ccccccj123/c8t6_control_mecanum/docs/superpowers/specs/2026-04-24-stm32f103-mecanum-car-design.md

# STM32F103C8T6 麦轮小车 Keil 工程设计说明

## 目标

创建一个可在 Keil uVision 中打开和编译的 STM32F103C8T6 工程，用于驱动四轮麦轮小车。硬件包括：

- STM32F103C8T6 最小系统板
- 网上常见 TB6612 四路电机驱动模块
- 四个 12V 333rpm 520 霍尔编码器减速电机
- PS2 手柄和接收器

小车没有陀螺仪，因此控制目标是“轮速闭环 + 车体坐标系运动”，不做航向保持，也不做场地坐标系全向控制。

## 引脚设计

开发板可用引脚为 `PB0-PB15`、`PA0-PA12`、`PA15`、`PC13-PC15`、`5V`、两个 `3V3`、三个 `GND`、`VB` 和 `R`。`PA13`、`PA14` 保留给 ST-Link 下载调试。

### PS2 接收器

| 信号 | STM32 引脚 |
| --- | --- |
| `ATT` / `CS` | `PB12` |
| `CLK` | `PB13` |
| `DAT` | `PB14` |
| `CMD` | `PB15` |
| `VCC` | `3V3` |
| `GND` | `GND` |

### TB6612 电机控制

| 轮子 | PWM | IN1 | IN2 | 驱动通道 |
| --- | --- | --- | --- | --- |
| 前左轮 | `PA8` | `PB0` | `PB1` | TB6612 #1 A |
| 前右轮 | `PA9` | `PB10` | `PB11` | TB6612 #1 B |
| 后左轮 | `PA10` | `PA12` | `PA15` | TB6612 #2 A |
| 后右轮 | `PA11` | `PB4` | `PB5` | TB6612 #2 B |

四路 TB6612 模块如果有统一 `STBY` / `EN`，接到 `PB2`。`VM` 接 12V 电机电源，逻辑电源按模块要求接 `3V3` 或 `5V`，所有地线共地。`PC13` 保留给最小系统板板载 LED，`PB8/PB9` 保留给 OLED 软件 I2C。

### 霍尔编码器

| 轮子 | A 相 | B 相 | 实现方式 |
| --- | --- | --- | --- |
| 前左轮 | `PA0` | `PA1` | `TIM2` 编码器模式 |
| 前右轮 | `PA6` | `PA7` | `TIM3` 编码器模式 |
| 后左轮 | `PB6` | `PB7` | `TIM4` 编码器模式 |
| 后右轮 | `PA4` | `PA5` | `EXTI` 软件正交解码 |

第四路编码器不使用硬件定时器的原因是 `TIM1` 已经用于 `PA8-PA11` 四路硬件 PWM。若把 `TIM1` 改成第四路硬件编码器，就必须牺牲当前稳定的四路 20kHz PWM，改用软件 PWM 或外接 PWM 芯片。

电机编码器参数按 `11PPR * 30` 减速比计算，程序四倍频后约为 `1320 count/rev`。333rpm 空载速度换算到 10ms 控制周期约为 `73 count/10ms`，因此默认速度限幅设为 `SPEED_LIMIT_TICKS=35`、`SLOW_SPEED_TICKS=18`，适合初学者先低速调试。

## 固件架构

工程使用裸机寄存器方式，不依赖 HAL 或标准外设库。这样 Keil 安装好后可以直接编译，不需要额外下载 STM32 固件库。

代码按职责拆分：

- `Core/`：系统时钟、主循环、配置参数、最小寄存器定义。
- `Drivers/`：GPIO、PWM、TB6612、编码器、PS2、SysTick。
- `Drivers/led.*`：PC13 板载 LED 心跳，用于最小系统板基础验证。
- `Drivers/oled.*`：PB8/PB9 软件 I2C OLED，用于显示 PS2 和编码器调试信息。
- `App/`：PID、麦轮运动学、整车控制逻辑。
- `Startup/`：启动文件和中断向量表。
- `docs/`：接线说明和设计记录。
- `tests/`：可在电脑上运行的核心算法测试。

## 控制流程

主循环每 10ms 执行一次控制：

1. 读取 PS2 手柄。
2. 将摇杆值转换为前后、左右、自转三个速度命令。
3. 使用麦轮运动学计算四个轮子的目标速度。
4. 读取四个编码器在当前周期内的计数增量。
5. 四个轮子分别运行 PID。
6. 将 PID 输出转换为 TB6612 方向引脚和 TIM1 PWM 占空比。
7. 主循环同时让 PC13 LED 以 500ms 周期闪烁，并每 200ms 刷新 OLED 状态。

`START` 用于使能电机，`SELECT` 用于停车，`L1` 用于慢速模式。

## 验证方式

电脑端验证：

- `tests/test_mecanum_pid.c` 验证麦轮混控和 PID 的核心行为。
- `tools/verify_project.ps1` 检查工程文件、关键源码和引脚映射是否存在。
- Keil 工程 XML 可解析。
- 所有 C 文件可通过主机 GCC 语法检查。

硬件端验证仍需在 Keil 中编译、下载到 STM32F103C8T6，并按 `docs/wiring.md` 的第一次上电检查步骤进行。
