ccccccj123/c8t6_control_mecanum/docs/_pdf_preview/plan.png

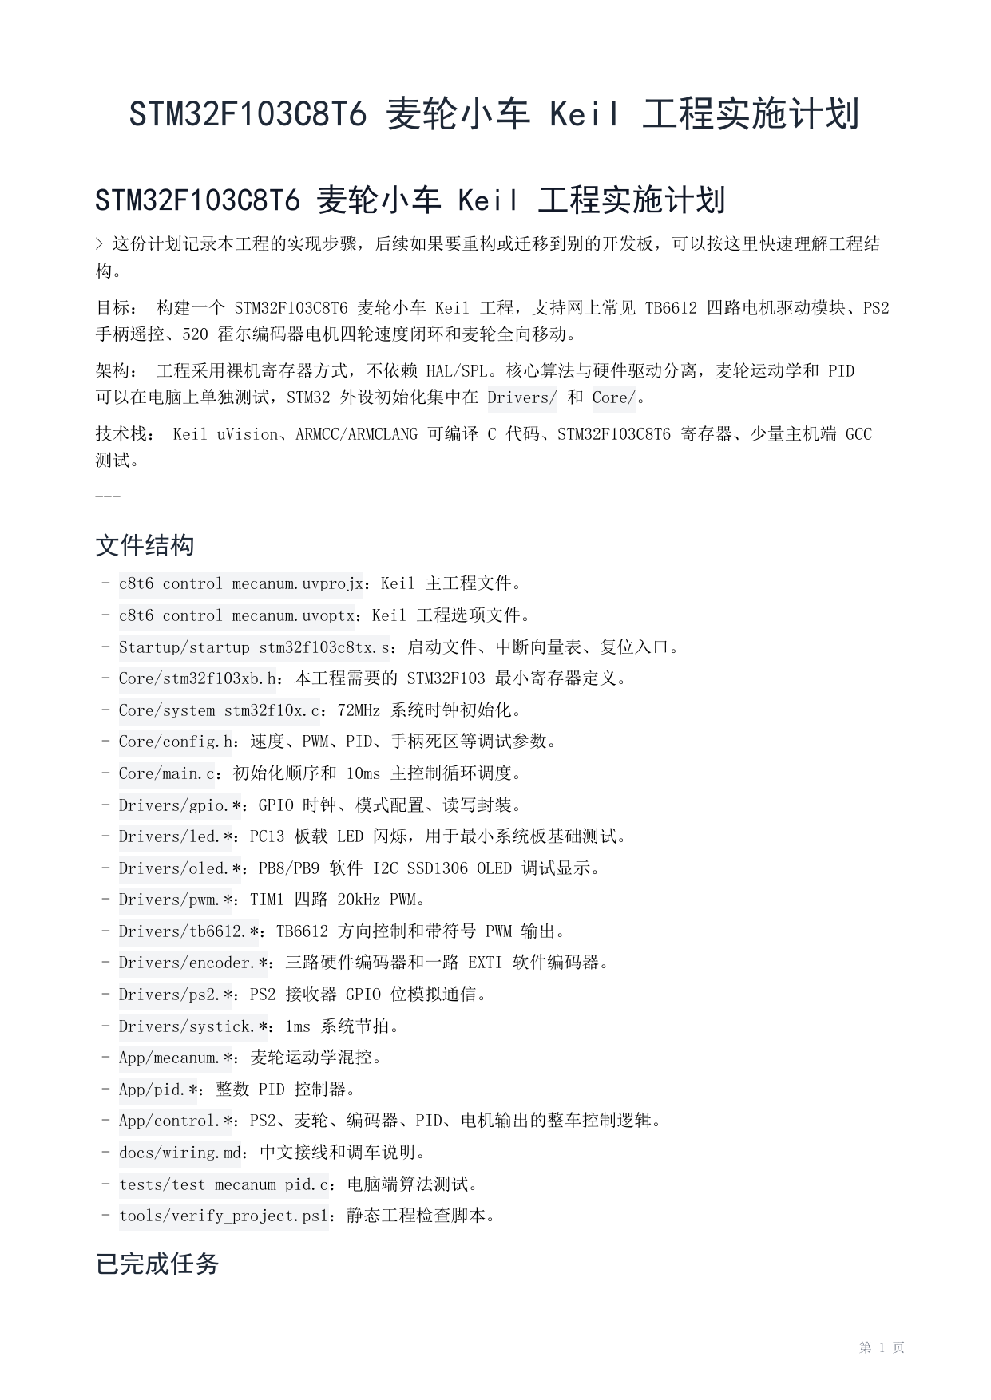
docs/_pdf_preview/plan.png
