ccccccj123/c8t6_control_mecanum/docs/_pdf_preview/spec.png

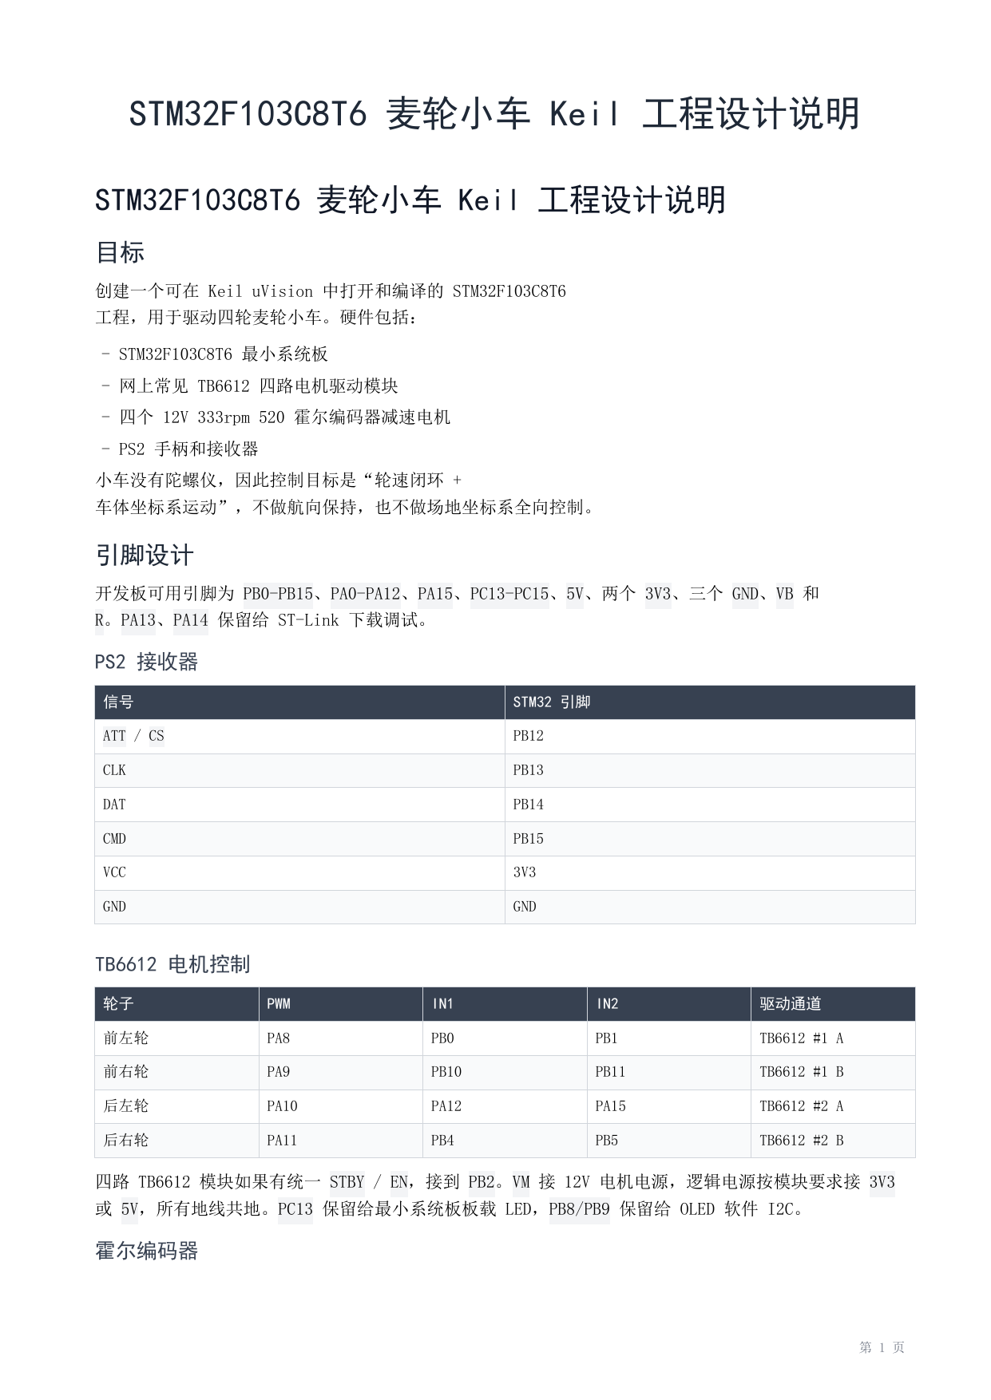
docs/_pdf_preview/spec.png
