ccccccj123/c8t6_control_mecanum/tmp/pdfs/design_page-1.png

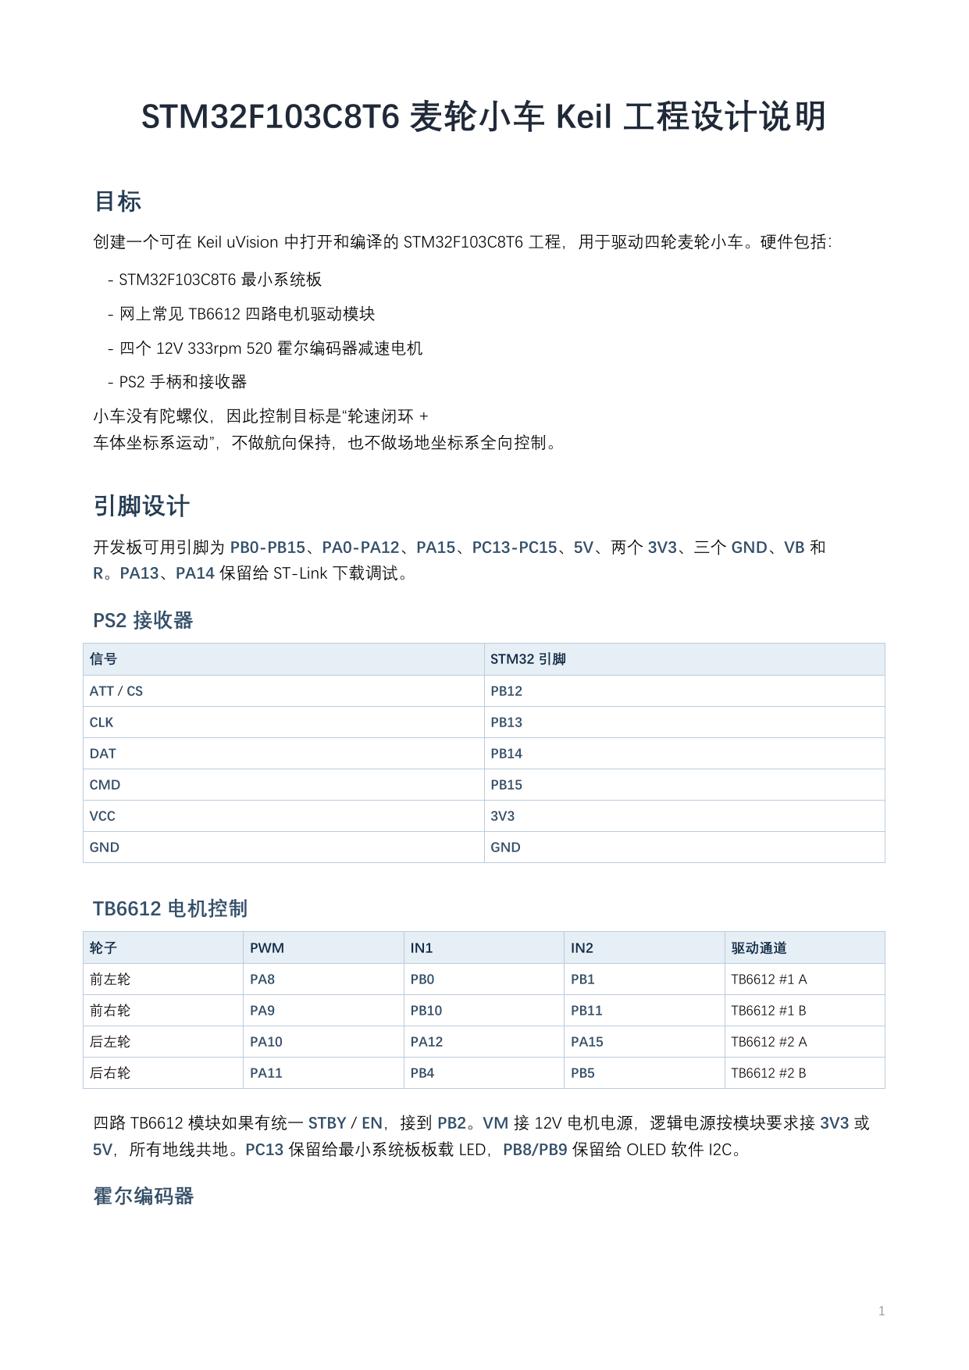
tmp/pdfs/design_page-1.png
