ccccccj123/c8t6_control_mecanum/tmp/pdfs/plan_page-1.png

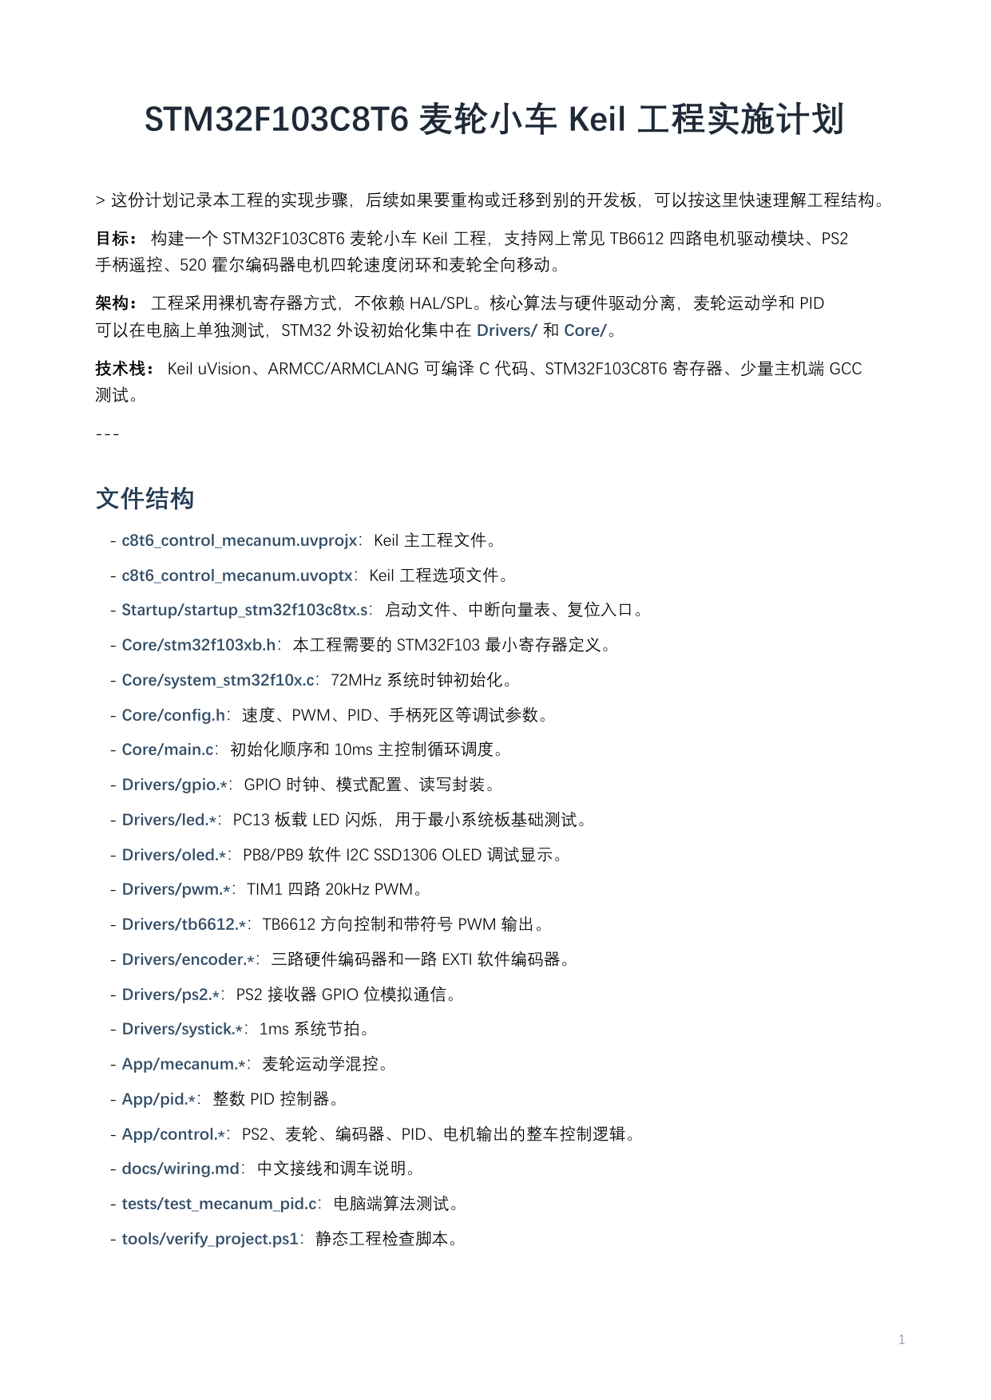
tmp/pdfs/plan_page-1.png
