ccccccj123/c8t6_control_mecanum/docs/wiring.md

# STM32F103C8T6 麦轮小车接线说明

## 开发板引脚

本工程按你提供的 STM32F103C8T6 最小系统板引脚来设计。可用引脚包括：

- `PA0-PA12`
- `PA15`
- `PB0-PB15`
- `PC13-PC15`
- `5V`
- 两个 `3V3`
- 三个 `GND`
- `VB`
- `R`

`PA13` 和 `PA14` 保留给 ST-Link 下载调试，也就是 `SWDIO` 和 `SWCLK`。不建议把它们接到电机驱动、编码器或 PS2 接收器上，否则后续下载程序会很难受。

## PS2 接收器

| PS2 信号 | STM32 引脚 | 说明 |
| --- | --- | --- |
| `ATT` / `CS` | `PB12` | 片选信号，由 STM32 拉低开始通信 |
| `CLK` | `PB13` | 时钟信号，由 STM32 输出 |
| `DAT` | `PB14` | 数据输入，PS2 接收器输出到 STM32 |
| `CMD` | `PB15` | 命令输出，STM32 输出到 PS2 接收器 |
| `VCC` | `3V3` | 建议接 3.3V，避免 IO 电平风险 |
| `GND` | `GND` | 必须与 STM32 和电机电源共地 |

PS2 通信使用 GPIO 位模拟，不占用硬件 SPI。这样布线简单，也避免和编码器/PWM 定时器抢资源。

## TB6612 四路电机驱动模块

本工程按网上常见的 TB6612 四路电机驱动模块来写。很多四路模块本质上是把两片 TB6612 或等效双路驱动集成到一块板子上，所以程序仍然按“四个通道，每个通道一个 PWM + 两个方向脚”的方式控制。

如果你的四路模块有统一的 `STBY` / `EN` 引脚，就接到 `PB2`，软件可以统一使能或急停。如果模块已经把 `STBY` 上拉或没有引出 `STBY`，`PB2` 可以不接，但建议优先按模块说明书接好。

| 轮子 | PWM | IN1 | IN2 | 四路驱动模块通道 |
| --- | --- | --- | --- | --- |
| 前左轮 `FL` | `PA8` | `PB0` | `PB1` | 第 1 块 A 通道 |
| 前右轮 `FR` | `PA9` | `PB10` | `PB11` | 第 1 块 B 通道 |
| 后左轮 `RL` | `PA10` | `PA12` | `PA15` | 第 2 块 A 通道 |
| 后右轮 `RR` | `PA11` | `PB4` | `PB5` | 第 2 块 B 通道 |

供电连接：

- TB6612 的 `VM` 接电机电源正极。如果你的最小系统板 `VB` 就是电池输入，可以按实际板子电源设计接 `VB`。
- TB6612 的 `VCC` 接逻辑电源。多数模块 3.3V/5V 都能识别，但建议优先按模块说明接。
- STM32、PS2、TB6612、电池负极、编码器地线必须共地。

`PC13` 已保留给最小系统板板载 LED。因为后右电机方向脚使用了 `PB4`，程序会关闭 JTAG、保留 SWD。下载调试仍然使用 `PA13/PA14`。

## OLED 调试屏

推荐使用常见 0.96 寸 SSD1306 I2C OLED。

| OLED 引脚 | STM32 引脚 | 说明 |
| --- | --- | --- |
| `SCL` | `PB8` | 软件 I2C 时钟 |
| `SDA` | `PB9` | 软件 I2C 数据 |
| `VCC` | `3V3` | 推荐 3.3V |
| `GND` | `GND` | 必须共地 |

## 520 霍尔编码器电机

当前电机参数：

| 项目 | 数值 |
| --- | --- |
| 电机类型 | 520 霍尔编码器减速电机 |
| 额定电压 | 12V |
| 输出转速 | 333rpm |
| 编码器基础脉冲 | 11PPR |
| 减速比 | 30 |
| 输出轴基础脉冲 | `11 * 30 = 330 PPR` |
| 程序四倍频计数 | `330 * 4 = 1320 count/rev` |

333rpm 是空载或接近空载转速。换算到程序里的 10ms 控制周期：

```text
333 rpm / 60 = 5.55 rev/s
5.55 rev/s * 1320 count/rev = 7326 count/s
7326 count/s * 0.01s = 73 count/10ms
```

 `Core/config.h` 里的 `SPEED_LIMIT_TICKS` 默认值已经改成：

```c
#define SPEED_LIMIT_TICKS 35
#define SLOW_SPEED_TICKS  18
```

这样约等于空载最大速度的一半，适合初学者第一次调车。确认方向、编码器、PID 都正常后，再逐步加大。

## 霍尔编码器接线

| 轮子 | 编码器 A 相 | 编码器 B 相 | 固件实现 |
| --- | --- | --- | --- |
| 前左轮 `FL` | `PA0` | `PA1` | `TIM2` 硬件编码器模式 |
| 前右轮 `FR` | `PA6` | `PA7` | `TIM3` 硬件编码器模式 |
| 后左轮 `RL` | `PB6` | `PB7` | `TIM4` 硬件编码器模式 |
| 后右轮 `RR` | `PA4` | `PA5` | `EXTI` 软件正交解码 |

如果编码器板用 5V 供电，请确认 A/B 相输出是否能安全接入 STM32。比较稳的做法是：

- 编码器输出为开漏/集电极时，用 3.3V 上拉；
- 编码器输出为 5V 推挽时，加电平转换或分压；
- 编码器线尽量短，电机线和编码器线分开走线。

## 为什么第四路编码器不用硬件编码器

STM32F103C8T6 可用于编码器模式的主要定时器是 `TIM1`、`TIM2`、`TIM3`、`TIM4`。

当前工程的资源分配是：

| 定时器 | 用途 |
| --- | --- |
| `TIM1` | `PA8-PA11` 四路 20kHz 硬件 PWM，控制四个 TB6612 PWM 输入 |
| `TIM2` | 前左轮硬件编码器 |
| `TIM3` | 前右轮硬件编码器 |
| `TIM4` | 后左轮硬件编码器 |

对这台 TB6612 四路驱动 + 520 霍尔电机麦轮小车来说，一路 EXTI 软件解码通常够用。

## 手柄控制

- 按 `START`：使能电机输出。
- 按 `SELECT`：停止电机输出。
- 左摇杆：控制前后/左右平移。W
- 右摇杆 X 轴：控制自转。
- 按住 `L1`：慢速模式，适合第一次调试。

本车没有陀螺仪，因此不能保持绝对航向。也就是说，小车旋转后，手柄“前进”永远是沿车头方向前进，而不是沿场地固定方向前进。

## 第一次上电检查

1. 先把车架垫起来，让四个轮子离地。
2. 只给 STM32 和 PS2 接收器供电，确认 Keil 还能通过 `PA13/PA14` 下载程序。
3. 接 TB6612 逻辑电源和电机电源，确认所有 `GND` 已经共地。
4. 按住 `L1`，再按 `START`，轻推摇杆，观察四个轮子方向。
5. 如果某个轮子电机方向反了，优先对调这个电机的两根输出线。
6. 如果对调电机线后速度闭环抖动或越跑越猛，再对调这个轮子的编码器 A/B 相。
7. 四个轮子方向都正确后，再调 `Core/config.h` 里的 `SPEED_LIMIT_TICKS`、`PID_KP`、`PID_KI`。

## PID 调试建议

先把车架离地调试，确认方向没错后再下地。

1. 先把 `PID_KI` 和 `PID_KD` 设为 0，只调 `PID_KP`。
2. 慢慢增大 `PID_KP`，直到轮速跟随明显，但不持续来回抖。
3. 加一点 `PID_KI`，改善低速时因为摩擦造成的转不动或速度偏低。
4. `PID_KD` 默认保持 0。霍尔编码器计数本身会有颗粒感，微分项容易放大噪声。
5. 如果小车一使能就冲得太猛，先降低 `SPEED_LIMIT_TICKS` 和 `PID_KP`。
6. 对当前 520 电机来说，`SPEED_LIMIT_TICKS=35` 已经是比较保守的起点；如果初学者仍然觉得快，可以先改成 20。
