ccccccj123/c8t6_control_mecanum/docs/_pdf_preview/wiring.png

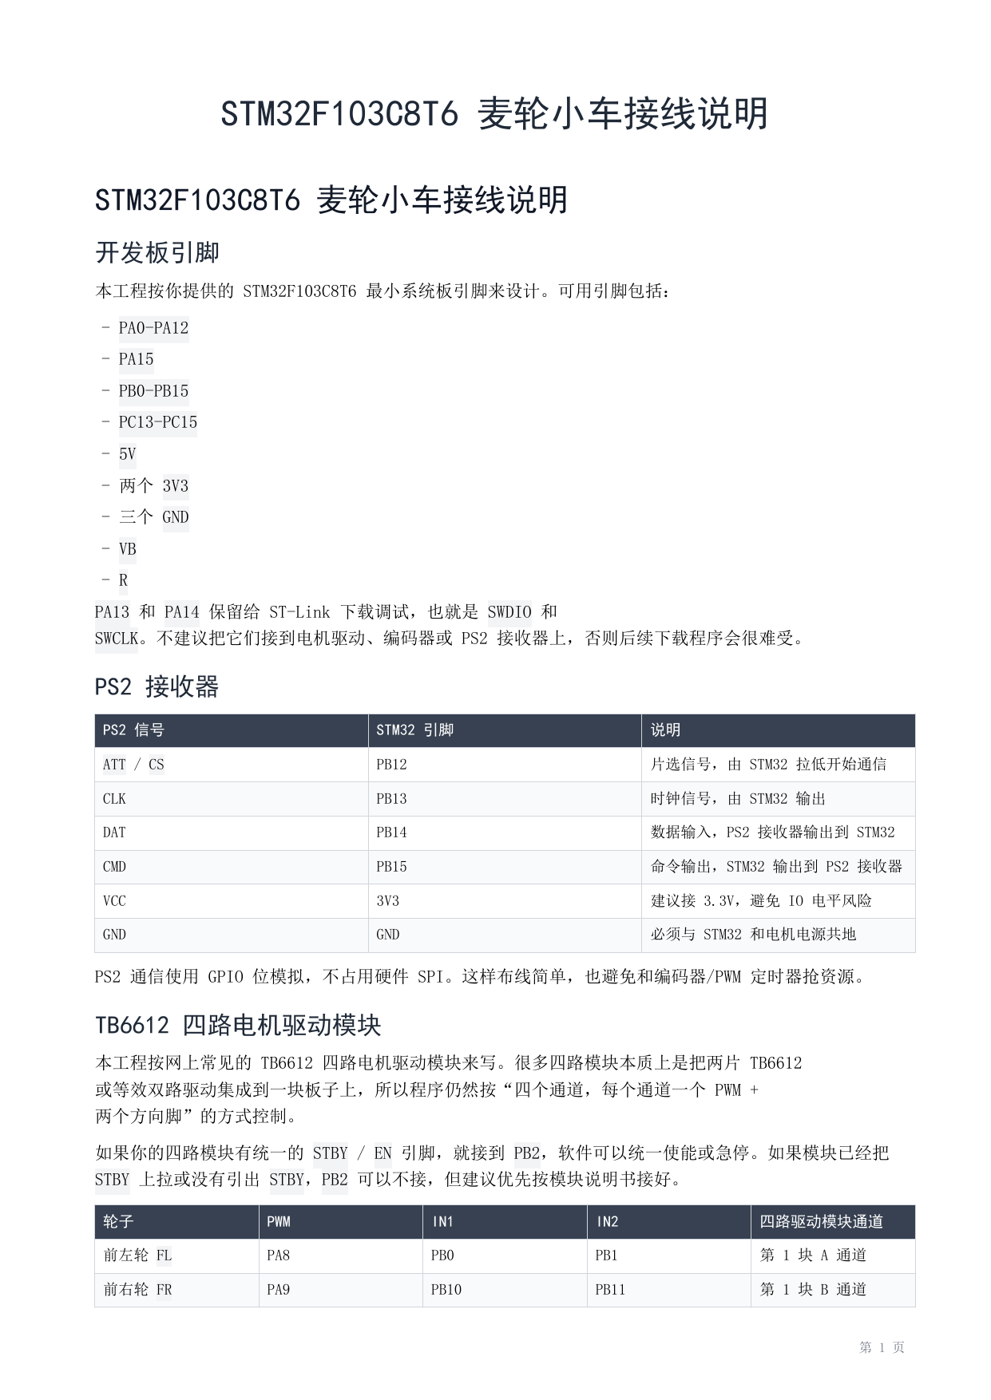
docs/_pdf_preview/wiring.png
