ccccccj123/c8t6_control_mecanum/tmp/pdfs/wiring_page-1.png

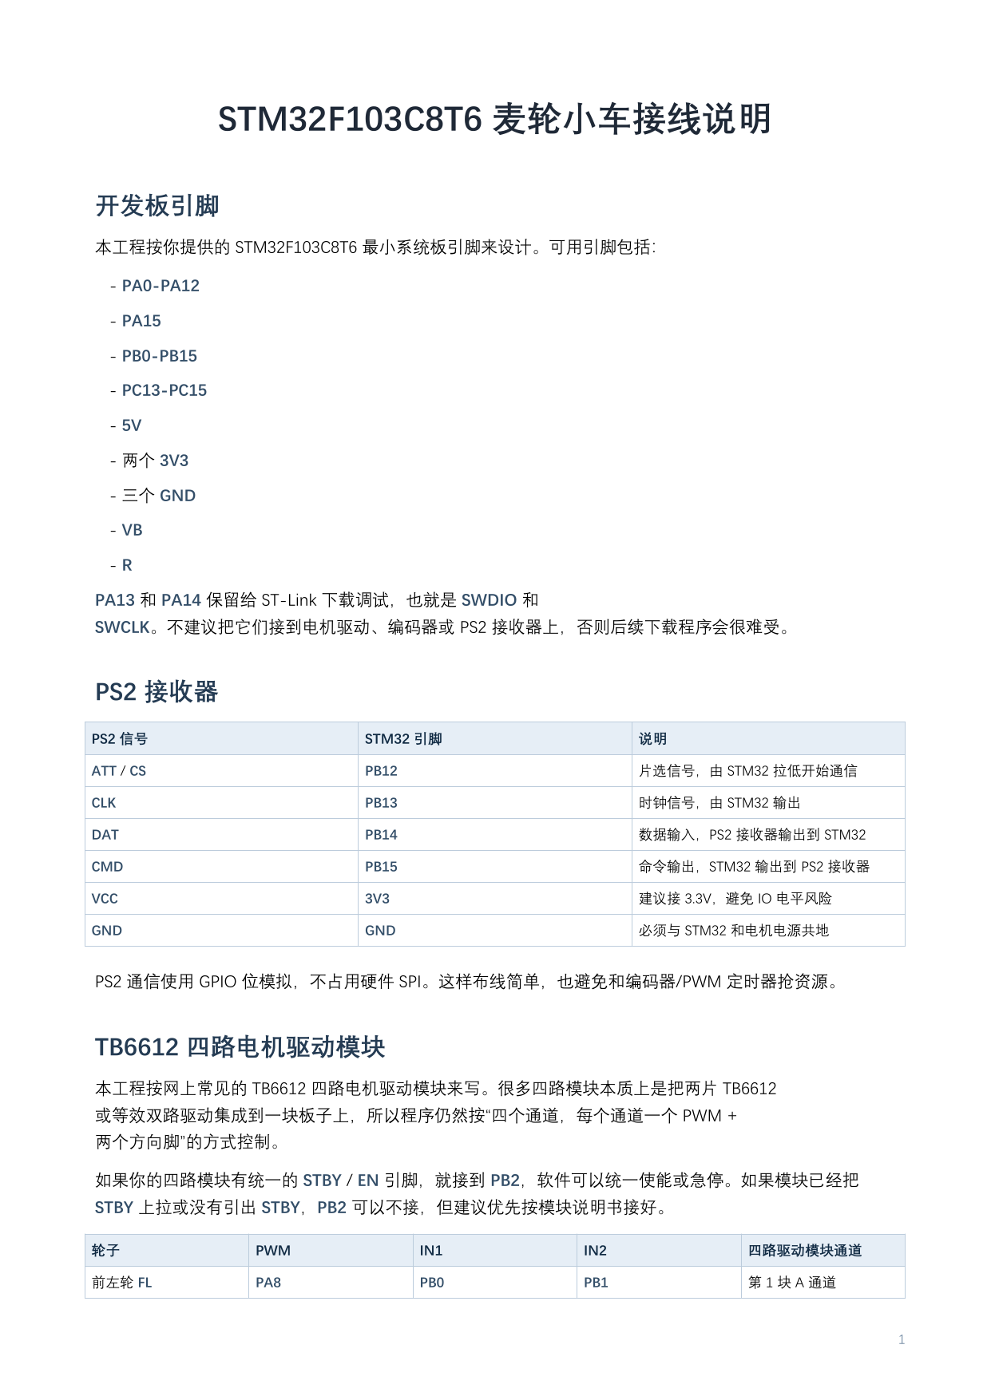
tmp/pdfs/wiring_page-1.png
