ccccccj123/c8t6_control_mecanum/docs/_pdf_preview/debug_flow.png

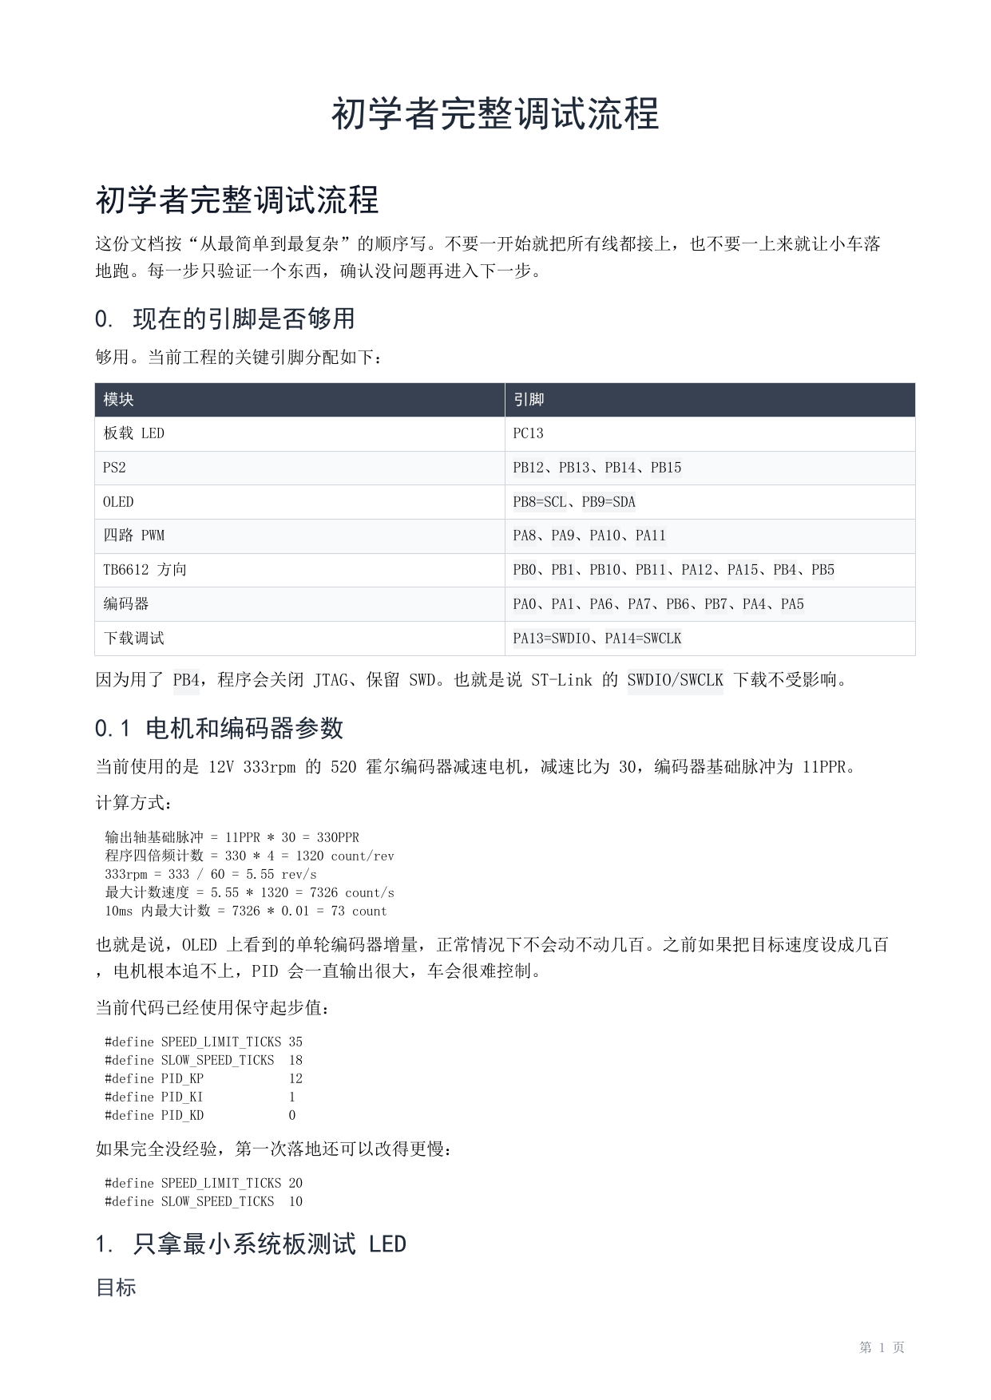
docs/_pdf_preview/debug_flow.png
