ccccccj123/c8t6_control_mecanum/tmp/pdfs/debug_flow_page-1.png

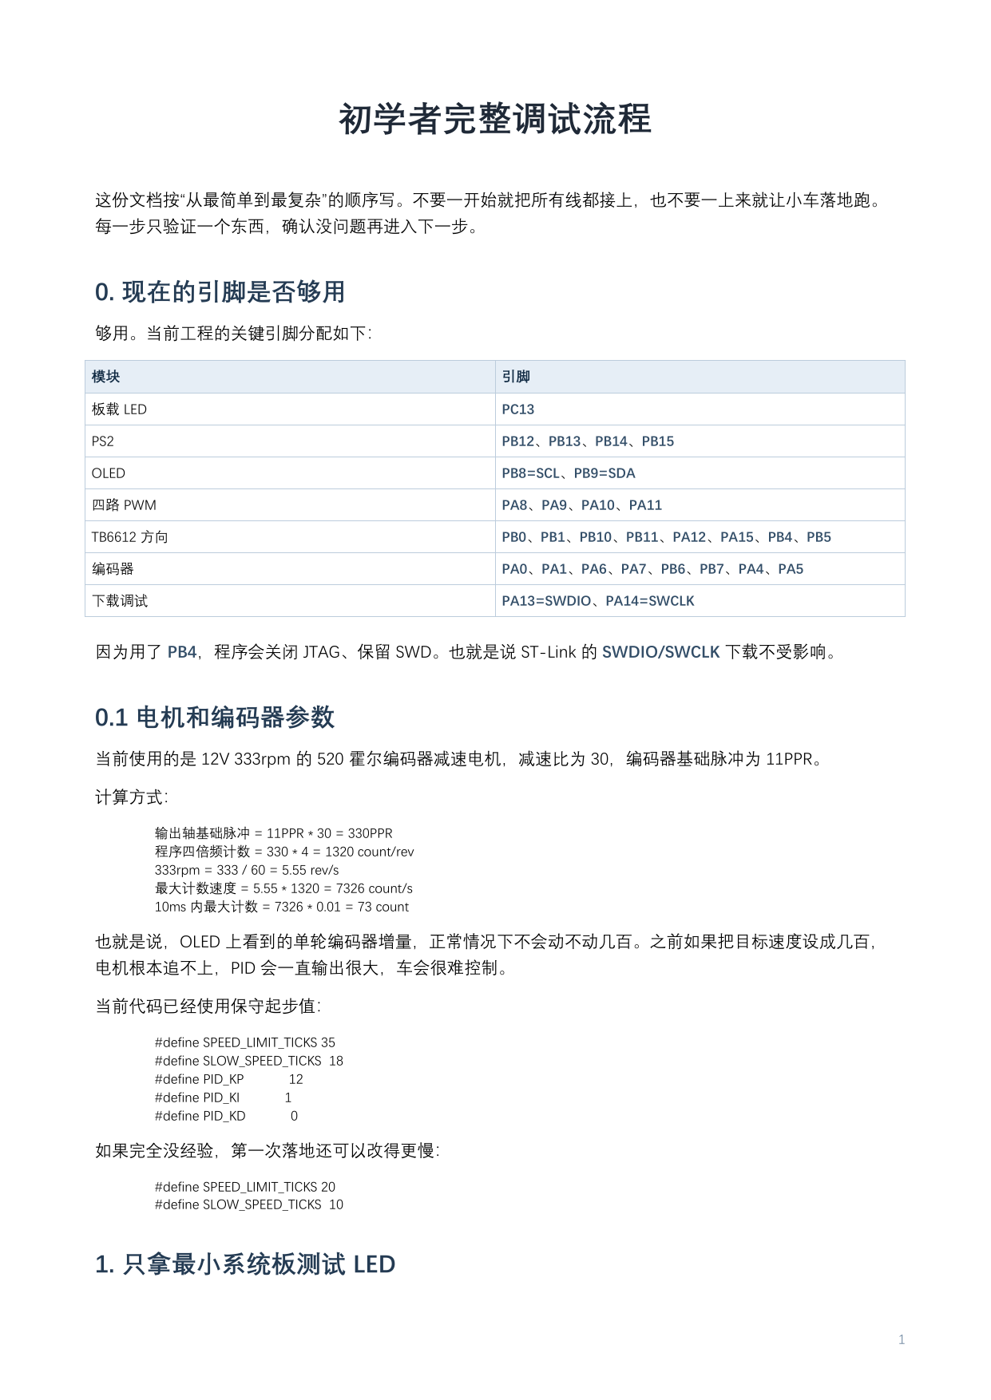
tmp/pdfs/debug_flow_page-1.png
