ccccccj123/c8t6_control_mecanum/Drivers/ps2.h

#ifndef DRIVERS_PS2_H
#define DRIVERS_PS2_H

#include <stdint.h>

#define PS2_BTN_SELECT    0x0001U
#define PS2_BTN_L3        0x0002U
#define PS2_BTN_R3        0x0004U
#define PS2_BTN_START     0x0008U
#define PS2_BTN_UP        0x0010U
#define PS2_BTN_RIGHT     0x0020U
#define PS2_BTN_DOWN      0x0040U
#define PS2_BTN_LEFT      0x0080U
#define PS2_BTN_L2        0x0100U
#define PS2_BTN_R2        0x0200U
#define PS2_BTN_L1        0x0400U
#define PS2_BTN_R1        0x0800U
#define PS2_BTN_TRIANGLE  0x1000U
#define PS2_BTN_CIRCLE    0x2000U
#define PS2_BTN_CROSS     0x4000U
#define PS2_BTN_SQUARE    0x8000U

#define PS2_MODE_DIGITAL          0x41U
#define PS2_MODE_ANALOG_RED       0x73U
#define PS2_MODE_ANALOG_PRESSURE  0x79U
#define PS2_STICK_NEUTRAL         128U

typedef struct {
    /* connected=0 表示本次通信没有识别到常见 PS2 手柄模式。 */
    uint8_t connected;

    /* 当前帧返回的手柄模式字节，常见值见上面的 PS2_MODE_*。 */
    uint8_t mode;

    /* 按键位：1 表示按下，已在 ps2_read() 中从低有效转换为高有效。 */
    uint16_t buttons;

    /* 四个摇杆轴原始值，通常 0-255，中位约 128。 */
    uint8_t rx;
    uint8_t ry;
    uint8_t lx;
    uint8_t ly;
} PS2State;

static inline uint8_t ps2_has_analog_sticks(const PS2State *state) {
    return (uint8_t)(state != 0 &&
                     (state->mode == PS2_MODE_ANALOG_RED ||
                      state->mode == PS2_MODE_ANALOG_PRESSURE));
}

static inline uint8_t ps2_should_enable_analog_mode(const PS2State *state) {
    return (uint8_t)(state == 0 || ps2_has_analog_sticks(state) == 0U);
}

static inline void ps2_sanitize_axes(PS2State *state) {
    if (state == 0) {
        return;
    }

    if (state->connected == 0U || ps2_has_analog_sticks(state) == 0U) {
        state->rx = PS2_STICK_NEUTRAL;
        state->ry = PS2_STICK_NEUTRAL;
        state->lx = PS2_STICK_NEUTRAL;
        state->ly = PS2_STICK_NEUTRAL;
    }
}

/* 配置 PB12-PB15 位模拟 PS2 接收器时序。 */
void ps2_init(void);

/* 读取一帧 PS2 数据，返回 1 表示识别到手柄。 */
uint8_t ps2_read(PS2State *state);

/* 判断某个按键是否按下。 */
uint8_t ps2_button_down(const PS2State *state, uint16_t button);

#endif
