ccccccj123/c8t6_control_mecanum/Drivers/gpio.c

#include "gpio.h"

void gpio_clock_enable(void) {
    RCC->APB2ENR |= RCC_APB2ENR_AFIOEN | RCC_APB2ENR_IOPAEN |
                    RCC_APB2ENR_IOPBEN | RCC_APB2ENR_IOPCEN;

    /*
     * 关闭 JTAG、保留 SWD。
     * 这样 PA13/PA14 仍可用 ST-Link 下载调试，同时释放 PA15/PB3/PB4。
     * 本工程 PA15 用作后左电机方向脚，PB4 用作后右电机方向脚。
     */
    AFIO->MAPR = (AFIO->MAPR & ~AFIO_MAPR_SWJ_CFG_MASK) | AFIO_MAPR_SWJ_CFG_NOJTAG;
}

void gpio_config(GPIO_TypeDef *port, uint8_t pin, uint8_t mode, uint8_t cnf) {
    /*
     * STM32F1 每个 GPIO 引脚用 4bit 配置。
     * pin 0-7 在 CRL，pin 8-15 在 CRH。
     */
    uint32_t shift = (uint32_t)(pin & 0x7U) * 4U;
    uint32_t value = ((uint32_t)cnf << 2) | mode;
    __IO uint32_t *reg = (pin < 8U) ? &port->CRL : &port->CRH;
    *reg = (*reg & ~(0xFUL << shift)) | (value << shift);
}

void gpio_write(GPIO_TypeDef *port, uint8_t pin, uint8_t value) {
    if (value != 0U) {
        port->BSRR = 1UL << pin;
    } else {
        port->BRR = 1UL << pin;
    }
}

uint8_t gpio_read(GPIO_TypeDef *port, uint8_t pin) {
    return (uint8_t)((port->IDR >> pin) & 0x1U);
}
