ccccccj123/c8t6_control_mecanum/(commit log)

2026-04-24 初版代码
2026-04-24 修改注释
2026-04-24 第一版结束
2026-04-29 增加屏幕摇杆值显示
